Jana-Marie/IBM-dials-retrofit/cdc-dials/README.md

# CDC implementation for IBM-dials-retrofit

Does currently not work, needs debugging.

 Build with `make`

 Flash with `dfu-util -a 0 -s 0x08000000:leave -D build/cdc-dials.bin`

 Todo:

  - [ ] Debug
  - [ ] Add example
