Jana-Marie/IBM-dials-retrofit/3D-files/README.md

# 3D printing files

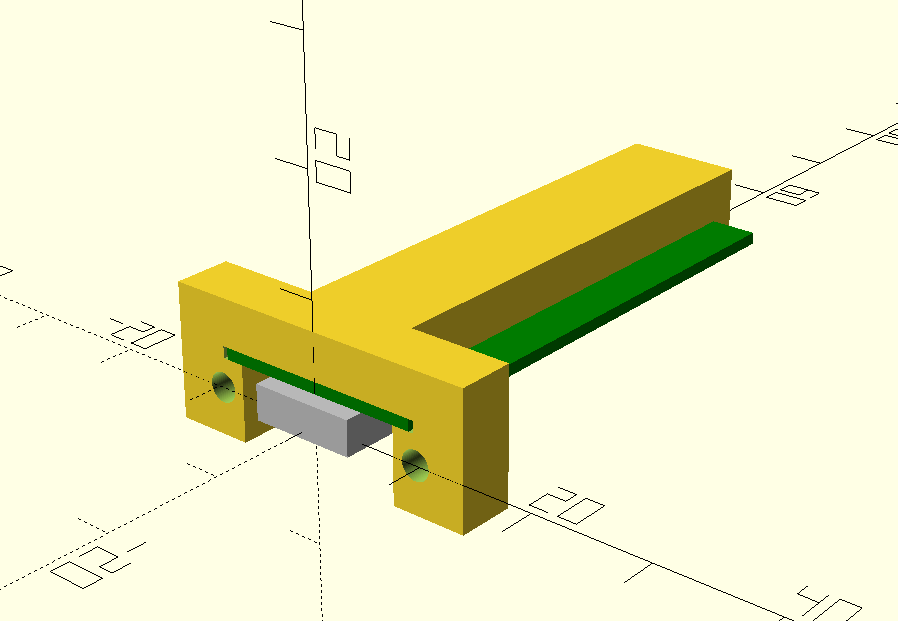
[picture p9: images/3d_1.png]
