Jana-Marie/IBM-dials-retrofit/3D-files/dials.stl

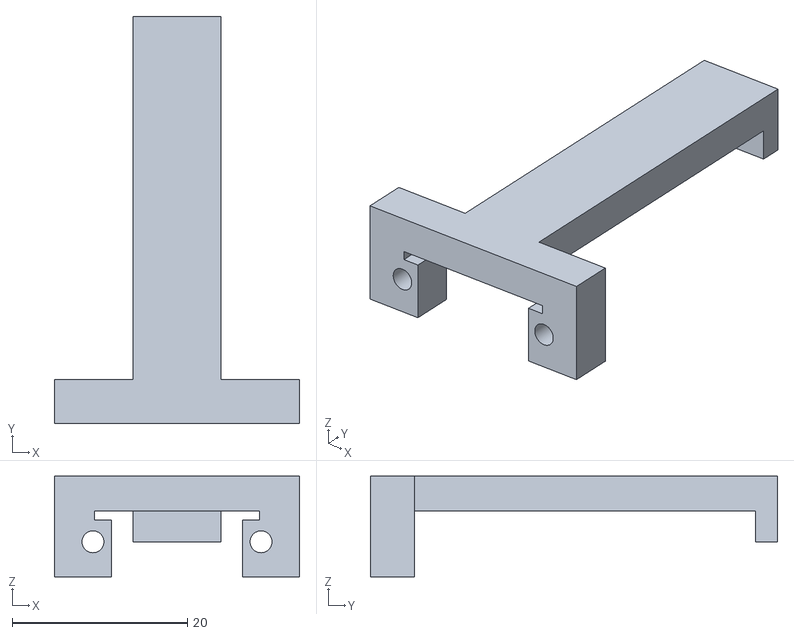
[picture p10: CAD file, 2020-04-01]
3D-files/dials.stl
28.0 x 46.5 x 11.5
