Jana-Marie/IBM-dials-retrofit/midi-dials/midi-dials.ioc

Mcu.UserName=STM32F072CBUx
PA0.Signal=ADC_IN0
PA1.Signal=ADC_IN1
PA11.Signal=USB_DM
PA12.Signal=USB_DP
PA13.Signal=SYS_SWDIO
PA14.Signal=SYS_SWCLK
PA2.Signal=ADC_IN2
PA3.Signal=ADC_IN3
PA4.Signal=ADC_IN4
PA5.Signal=ADC_IN5
PA6.Signal=ADC_IN6
PA7.Signal=ADC_IN7
PB0.Signal=ADC_IN8
