Jana-Marie/IBM-dials-retrofit/(commit log)

2020-03-31 added 3D printer files
    [dials.scad]
2020-03-31 renamed folder
    [dials.scad]
2020-04-01 added stl
    [dials.stl]
